rebelpg/Project/webimages/3.webp

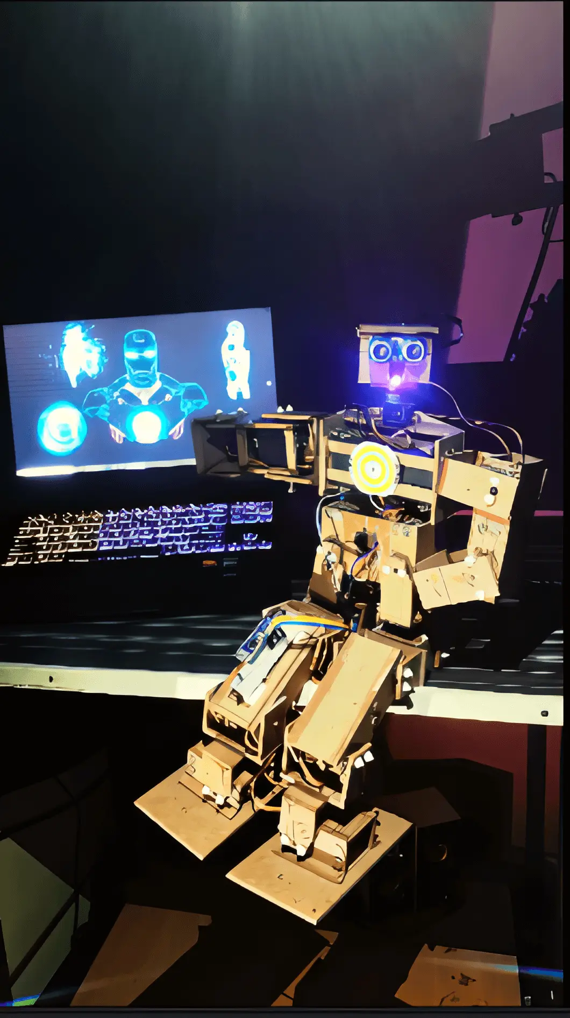
webimages/3.webp
