rebelpg/Project/webimages/5.webp

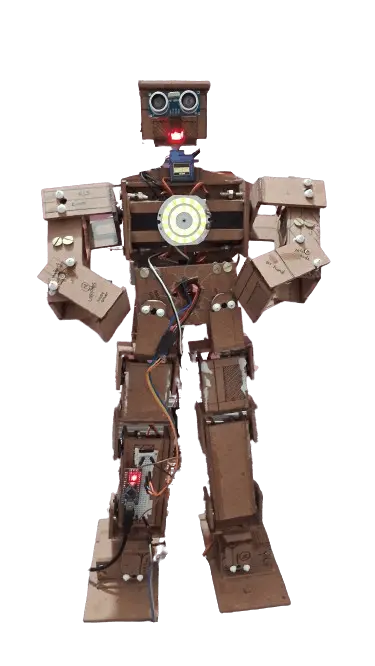
webimages/5.webp
