rebelpg/Project/webimages/6.webp

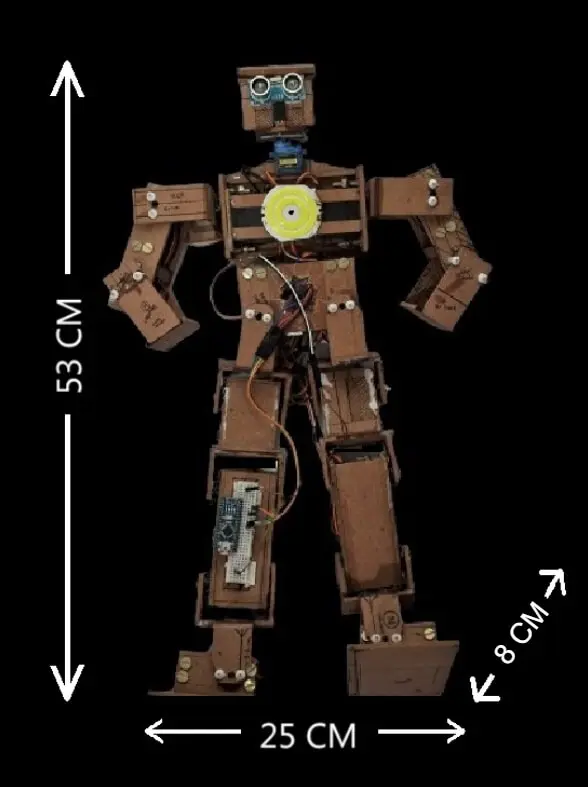
webimages/6.webp
