rebelpg/Project/webimages/3000.webp

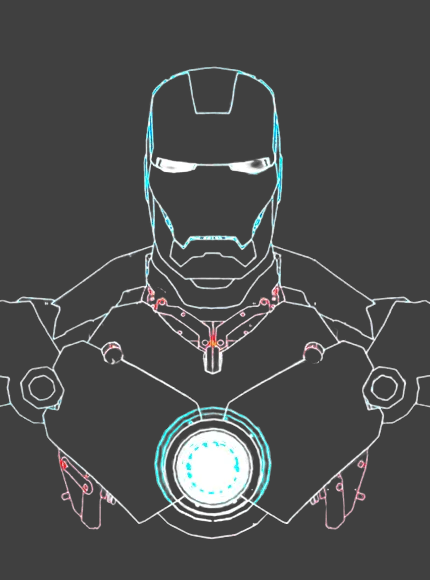
webimages/3000.webp
