rebelpg/Project/webimages/circuit/circuitesp32.webp

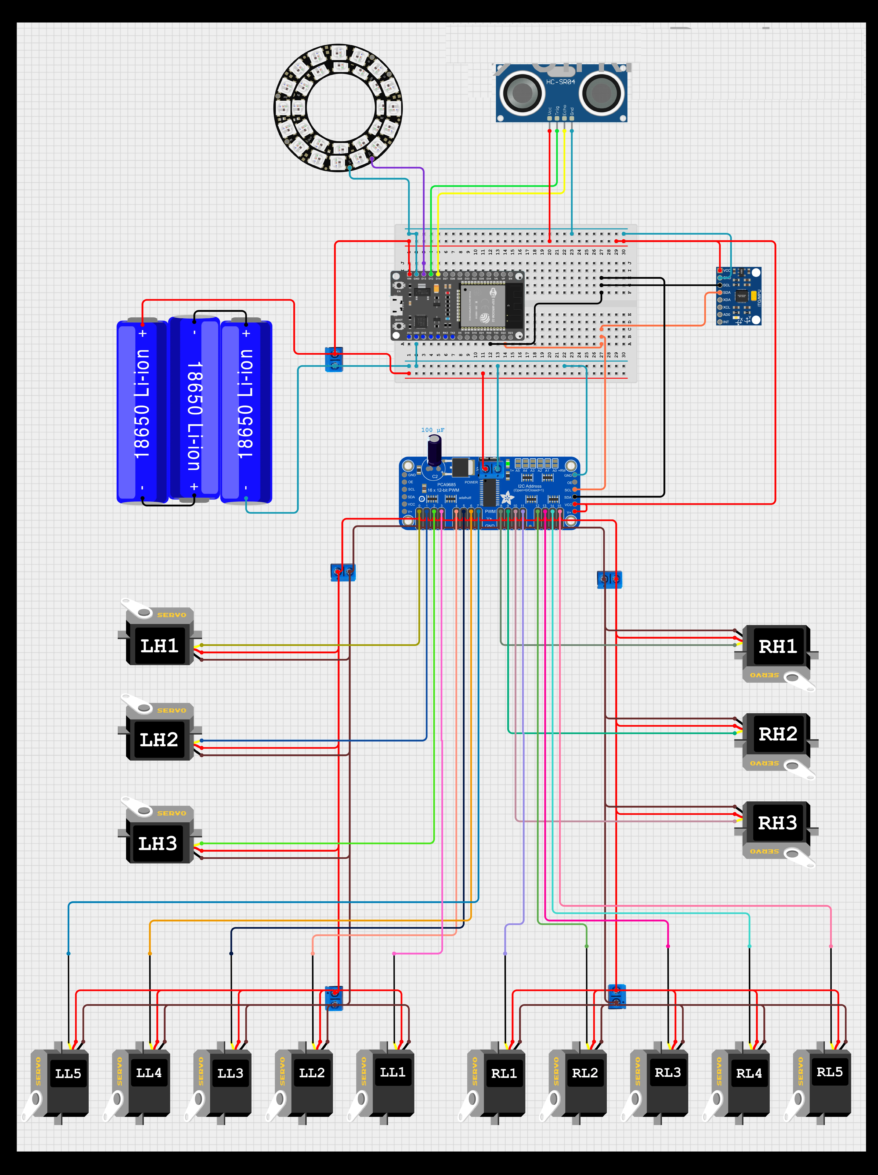
webimages/circuit/circuitesp32.webp
