rebelpg/Project/webimages/circuit/circuitnano.jpg

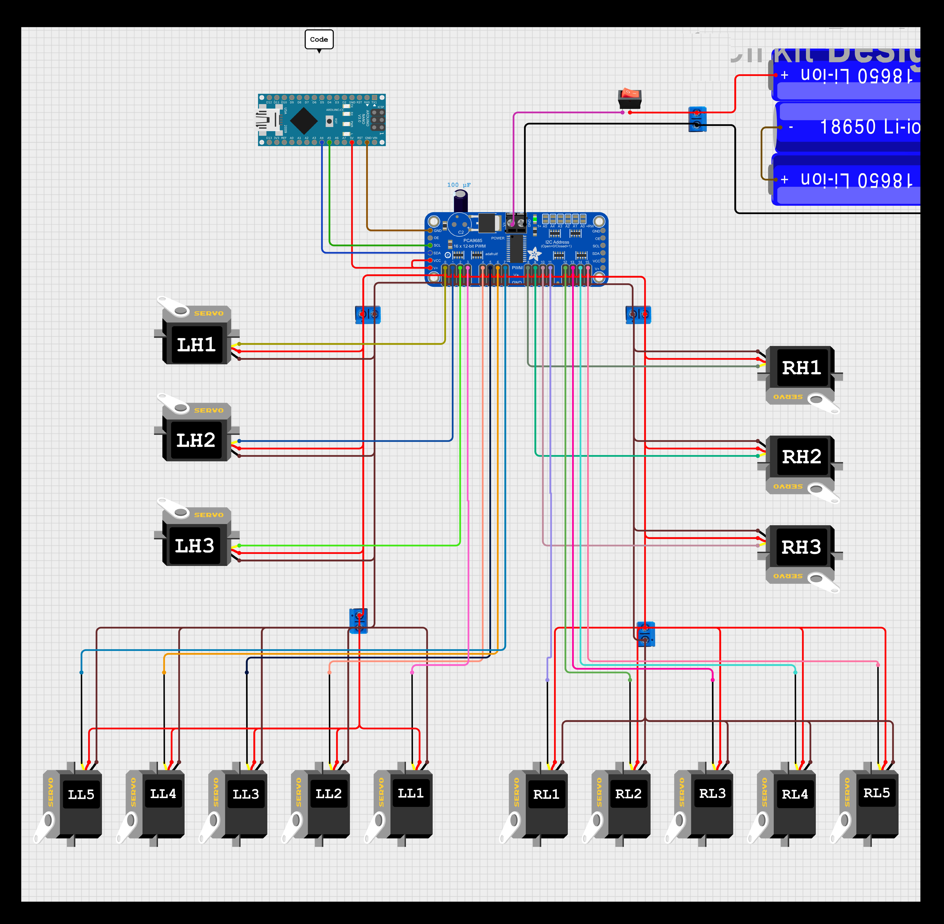
webimages/circuit/circuitnano.jpg
