rebelpg/Project/webimages/g1.gif

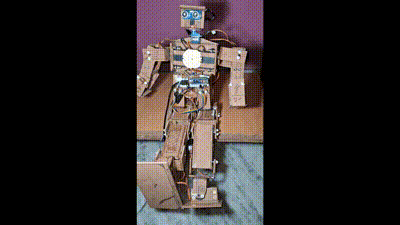
webimages/g1.gif
