rebelpg/Project/webimages/g2.gif

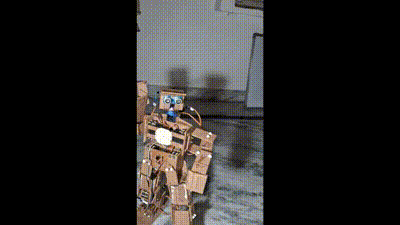
webimages/g2.gif
