rebelpg/Project/webimages/g3.gif

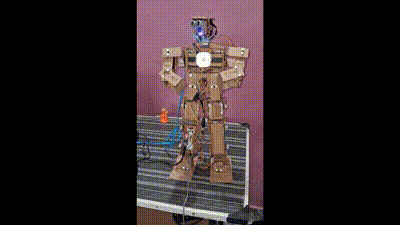
webimages/g3.gif
