rebelpg/Project/webimages/hardware/esp32.webp

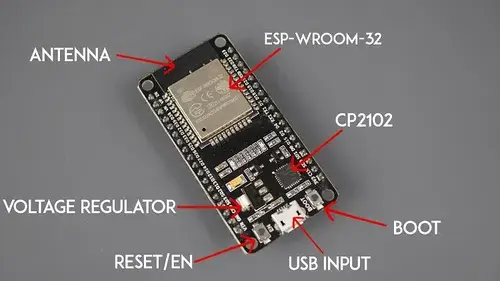
webimages/hardware/esp32.webp
