rebelpg/Project/webimages/hardware/hcsr04.webp

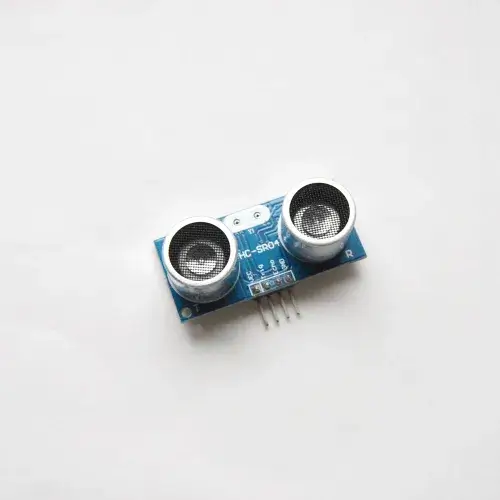
webimages/hardware/hcsr04.webp
