rebelpg/Project/webimages/hardware/mg995.webp

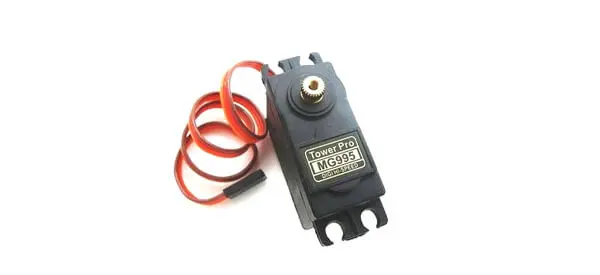
webimages/hardware/mg995.webp
