rebelpg/Project/webimages/hardware/mpu6050.webp

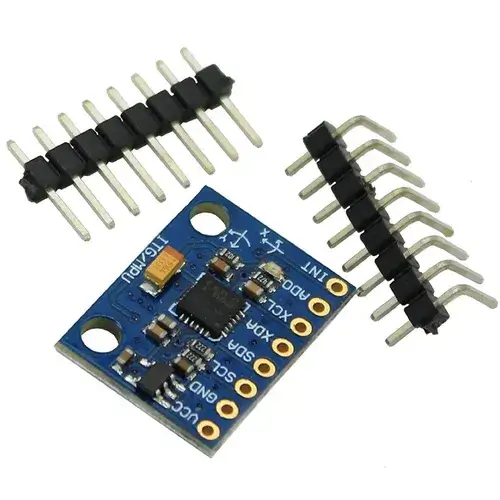
webimages/hardware/mpu6050.webp
