rebelpg/Project/webimages/hardware/nano.webp

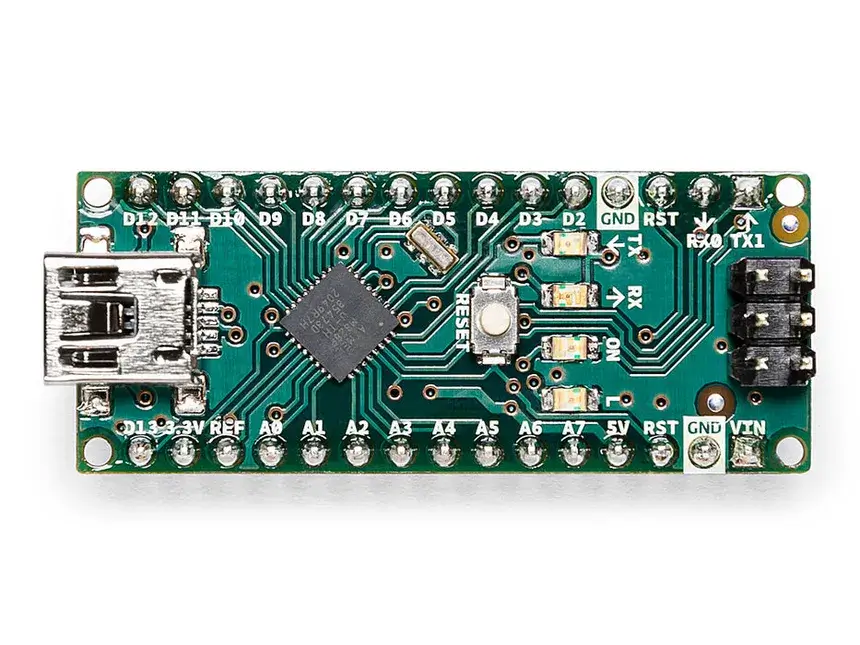
webimages/hardware/nano.webp
