rebelpg/Project/webimages/hardware/pca9685.webp

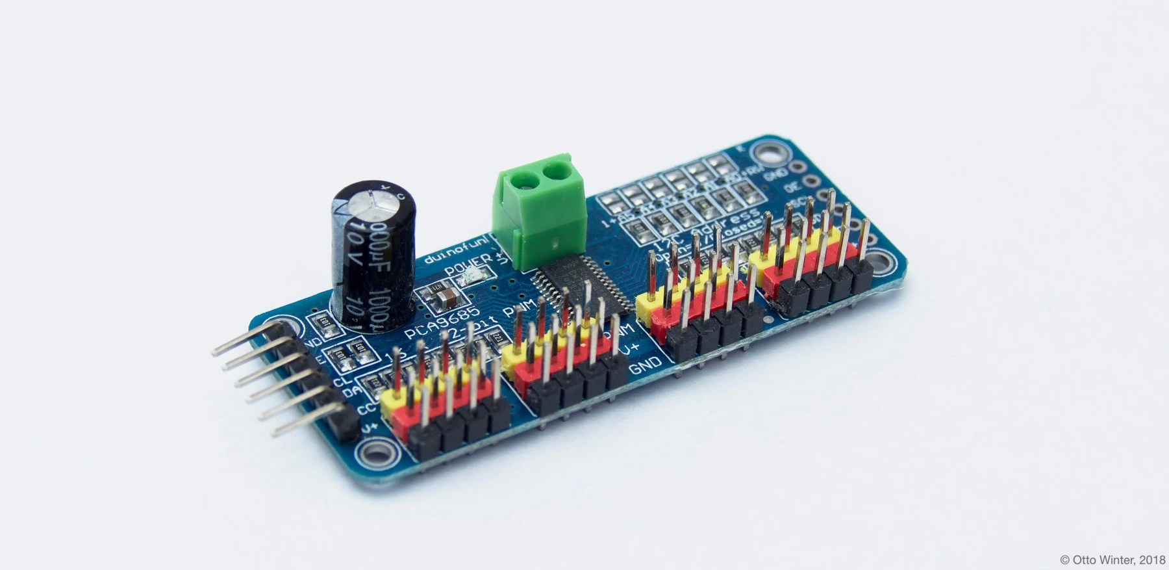
webimages/hardware/pca9685.webp
