rebelpg/Project/webimages/hardware/sg90.webp

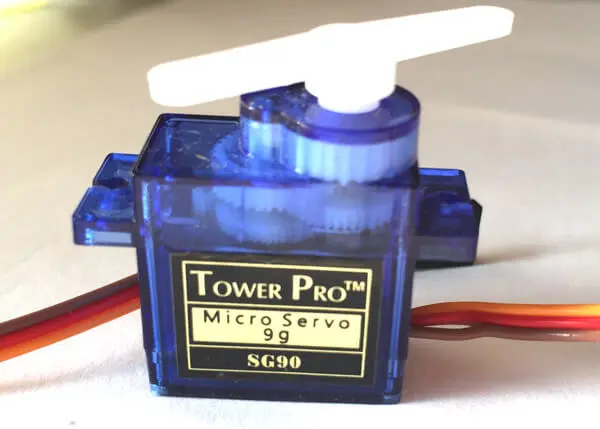
webimages/hardware/sg90.webp
