rebelpg/Project/webimages/led.webp

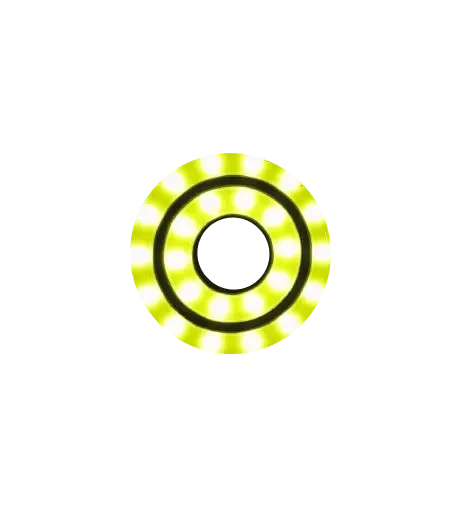
webimages/led.webp
